ARC-RODRIGUES/Sistema-de-Irriga-o-Automatizado/README.md

# Sistema-de-Irriga-o-Automatizado
Sistema de Irrigação Automatizado Controlado por Sistema Arduino Uno R3
